necroware/nwX287/(threads)

Thread 1 (2021-10-04):

Share your project on PCBWay

kalgon, 2021-10-04:
Hi,

Could you share your project directly on PCBWay (https://www.pcbway.com/project/shareproject/) ?

It would be easier to order PCBs and you could get some money too ;-)

Regards,
Xavier

necroware, 2021-10-04:
Hi Xavier,

may be one day. I don't want to spread my projects all over the place, it makes it harder to maintain them and keep the versions up to day. I mean PCB Way is not the only one manufacturer. I'm also currently not registered on PCB Way and I don't think that I will get a lot of money from it anyway. I'll keep this request open for now, may be I'll change my mind one day.

However, it is currently super easy as well. I guess, everybody is able to drag and drop a file and if not, probably, my projects are not the right thing :D

Cheers,
Filipp

Closed 2023-12-30.

Thread 2 (2021-11-25):

Compatibility with the *B* and *C* variants

Jackowski3k, 2021-11-25:
Hello.

Out there are multiple versions of the Dallas RTC chip, among them the DS12B887 and DS12C887
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

How does it looks with the compatibility? I have tried various alternatives I could find online and they didn't worked on my systems.

necroware, 2021-11-25:
You can use this module with different ICs, so it is heavily dependent on what you are using. I used it with BQ3285 and BQ4285 depending on the mainboard requirements and both variants worked perfectly. Due to the datasheets the DS12C885 (used in DS12C887) is an extended version of the DS12B885 (used in DS12B887), which is again an extended version of the DS1285. The extended versions are a drop-in replacement for the older versions accordingly. The BQ3285 should be identical with DS12C885 and I had no mainboards so far, where it didn't work.

steeviebops, 2023-07-12:
This board, as built, is functionally equivalent to the DS12B887. The main difference between the 12887 and 12B887 is that the B variant exposes pin 21 of the internal RTC. This is the "RAM clear" pin, used for clearing CMOS settings via a jumper. Pin 21 is absent from a standard DS12887 module so it can't be cleared using the jumper method.

The DS12C887 contains an extra "century byte" so I imagine that the RTC would need to be different. I've seen some references to a DS12C885 but it seems to be hard to find.

necroware, 2023-12-30:
Thank you very much. I mentioned this in the documentation. The PCB itself exposes pin 21 already, so it is only a question of which pins to cut. I guess this can be closed.

Closed 2023-12-30.

Thread 4 (2021-12-14):

chips have the same code in kicad schematic

dataino-it, 2021-12-14:
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
chips have the same code in kicad schematic

necroware, 2021-12-14:
That's on purpose. The one represents the outer DIP and the other one the SO.

dataino-it, 2021-12-14:
Yes, I understood by opening the pcb

dataino-it, 2021-12-14:
can be. or 24 pin socket

necroware, 2021-12-14:
I renamed it simply in socket ;)

Closed 2021-12-14.

Thread 5 (2021-12-15):

Question about CR2025 vs 1225

atheros, 2021-12-15:
Hi,

Awesome job you did here, big thanks!

I want to order the components, but I see an issue. Readme calls for CR1220 / CR1225 battery holder while the silk screen layer has CR2025 marking.

So just to be sure, which is it? Or do all of those battery holders fit on the PCB?

Thanks!

ndemarco, 2021-12-17:
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

I'm seeing CR1220 in the silk layer.

The 2025 is a 20 mm diameter battery. The 12xx is a 12 mm diameter cell. They're not interchangeable.

necroware, 2021-12-17:
See #6

Closed 2021-12-17.

Thread 6 (2021-12-15):

Silk screen layer mentions CR2025 instead of CR1220/1225

atheros, 2021-12-15:
Hi,

Awesome job you did here, big thanks!

I want to order the components, but I see an issue. Readme calls for CR1220 / CR1225 battery holder while the silk screen layer has CR2025 marking.

So just to be sure, which is it? Or do all of those battery holders fit on the PCB?

Thanks!

necroware, 2021-12-15:
Oh, that's a mistake on the silk screen layer. The batter (holder) must be CR1220 (CR1225 is the same size). I'll fix the silk screen layer and make a fixed release.

necroware, 2021-12-15:
Fixed and release the new revision 1a:
https://github.com/necroware/nwX287/releases/tag/rev1a

Closed 2021-12-15.

Thread 7 (2021-12-17):

Include the symbol cache

ndemarco, 2021-12-17:
I'm fairly new to KiCad. Actually, I just installed it. I do use Altium for work, though.

It seems the symbol cache is missing.
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

necroware, 2021-12-17:
Kicad generates the *-cache.lib file automatically. Please don't use KiCad 5.99, that is a development version and you will have many issues using that one. The current official version is 5.1.12

necroware, 2021-12-17:
By the way, if you want just to order the PCBs, you don't need to use KiCad at all. Simply go into releases and download the gerber files, which you can use to make the order.  https://github.com/necroware/nwX287/releases

ndemarco, 2021-12-17:
Thank you 2x today (not seeing ver 1.a, not seeing I installed KiCad
preview). I really must wake up! Your videos are great. Very well done,
precise and clear.

KiCad interests me, so I prefer to go that way.

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

necroware, 2023-12-30:
done

Closed 2023-12-30.

Thread 9 (2022-09-02):

Xtal

jcarval, 2022-09-02:
Hi, my friend, can I solder the crystal in any way or the xtal has a like + and - side like capacitors? (sorry my nob question about crystals)
I have ordered some from alliexpress and they some have no marking and the legs are the same size.
In the photos you supplied I can see that some lettering in them, but could be coincidence .
Thank you!
Jorge

necroware, 2022-09-02:
Hi Jorge! You can solder it either way, they don't have polarity.
Cheers!

Closed 2022-12-05.

Thread 10 (2022-11-22):

"cmos checksum error defaults loaded" with BQ3285S RTC

theniwo, 2022-11-22:
Hi all.

I assembled an RTC-Module with the [nwX287](https://github.com/necroware/nwX287) PCB and a [BQ3285S](https://www.ebay.de/itm/324259367588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) RTC.

Now I am getting the "cmos checksum error defaults loaded".

The Battery Error is not indicated and the battery is fresh and has voltage.

I testet

* Loading BIOS or Setup defaults

* Flashing the BIOS with the latest ([WI7C 040197](https://theretroweb.com/motherboard/bios/wi7c-5f5ab87c0cb5d152278531.exe)) Award from [theretroweb](https://theretroweb.com/motherboards/s/msi-ms-5129-tr5#downloads)

* Checked continuity on all pins and legs on the RTC Module

What I noticed was that the time drifted forward and the seconds where erroraneous.

It goes like this: 1 - 19, 40, 0

What is going on here? Did I use the wrong RTC Chip?

May it be a counterfeit?

Did I damage it because it got a bit hot during soldering?

Can I rule the BIOS EEPROM out since it should be an issue with the RTC?

I have the original ODIN OEC12C887. Should I mod it to rule the BIOS EEPROM out?

necroware, 2022-12-05:
May be the BQ3285S is defective. The BIOS chip is not related.

necroware, 2023-12-30:
I don't think, that this is related to the module itself. Looks like an incompatibility or defect of the chip itself.

theniwo, 2025-05-22:
I changed the IC and it works now. The one I had was probably defective, or a counterfeit

Front:
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

Back
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

Working IC
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

Closed 2023-12-30.

Thread 11 (2022-11-26):

BQ3287MT

adamz464, 2022-11-26:
Unfortunately doesn't work (Alaris Cougar)...

necroware, 2022-12-05:
Ok, then I'd like to know, which module was previously in there, if the board works reliably with the original IC and what means "doesn't work"? Black screen, no boot, no POST codes?

adamz464, 2022-12-29:
BQ3287MT. Tested on both identical motherboards and with BQ3285S / LCS.

No boot (black screen). Some beeps are but didn't check about meaning (it
is MrBios)

necroware, 2022-12-29:
If it is beeping, the RTC module is probably ok. Usually the boards doesn't even get to the POST codes if the RTC module is dead. If it is beeping, then the basic initialization has been done successfully.

adamz464, 2023-01-17:
Accidentally got Alt12887 with DS12885S chip. It worked with this one picky
motherboard (Alaris Cougar).
So I desoldered DS chip and prepared next unit of NWX based on it. Result
the same (no screen).
Must compare pinout of these proejcts because must be difference between
them...

adamz464, 2023-01-17:
Found issue: #21 pin is present in ALT. After soldering this leg back to
your module then mobo boots

adamz464, 2023-01-26:
and...

> Message ID: ***@***.***>
>

adamz464, 2023-02-15:
and...

> Message ID: ***@***.***>
>

adamz464, 2023-02-28:
AND

necroware, 2023-02-28:
Ok, most mainboard don't use that pin, but yours seems to use it. This is the first one so far. I'll have to update the documentation and test what happens if I use it with pin 21 in another boards.

Thread 17 (2023-12-30):

Please add pin 1 silkscreen markings for the clock chip

feltel, 2023-12-30:
Recently I have had produced some PCBs using your fantasic dallas clock module replacements. I'm now in the process of assembling one module. It seems there is no (identifieable) pin 1 marking on the silkscreen for the clock chip. Looking around it seems that pin 1 is towards the crystal. To make thinks clear please add a marking on the silkscreen.

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

Thanks alot and have a nice 2024.

necroware, 2023-12-30:
The pin one is already marked by the footprint of the library. There is no need to add own markings.

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

Closed 2023-12-30.

Thread 19 (2024-03-12):

Use of RCL pin 21

shalseth, 2024-03-12:
First of all, thanks for this project. Looks like it's exactly what I need, and I appreciate the effort.

I have ordered a nwx287 to replace a Dallas  DS12887.

I'm unsure about this:
"Important: some mainboards seem to use /RCL pin 21, so cut it first if you are sure, that your mainboard doesn't use it."

Is there any safe way I can find out if my main board uses the RCL pin or not?

Any risk _not_ cutting and, and testing first?

The machine is a DEC Venturis 5100, Pentium 100, SIS 5501 chipset.

Text on Dallas module:
Dallas
DS12887
REALTIME
9538A2 067579

shalseth, 2024-03-12:
I'm closing as I guess it is sufficient to check the  pins on the original module in question

Thread 20 (2024-05-30):

Implementing DS1643 suppoort

Deftaudio, 2024-05-30:
Hi, just wondering if there is any way to implement DS1643 support which is 8k device?

necroware, 2024-05-30:
H, this is a completely different module. This project is to replace DS12887 and compatible modules, so the question if something different can be implemented is kind of unrelated. Even if DS1643 is also an RTC module, it's still another one.

If you have your old module, may be this video can be helpful to you:
https://youtu.be/ecTZtZhE9bI

Deftaudio, 2024-05-30:
I appreciate this, thank you, this video explains it very well.

Closed 2024-05-30.

Thread 23 (2025-07-20):

2 modules died

squelch41, 2025-07-20:
Hi,
1st of all, thank you for this project (and your great YT videos)
I have had 2 of these modules and fitted them to an  ICL NB386S laptop (a rebaged siemens-nixdorf PCD-3Nsx) - 386 sx machine, dalas clock.

The first one failed after a few days - would crash on start up often before bios beep and lose all bios settings - I think the internal memory on the bq3285s failed.
The the second one now has a failed clock - the setting save and the bios gets through ok but time is always lost.

It's possible I just have been unlucky and had 2 defective chips, but it seems a bit odd?

Just wondering if there is a way these modules could be being fried?

squelch41, 2025-07-20:
That's interesting, thanks.

At first glace, the RTC clock, once set, does keep time.
If I manually set the time in DOS, then checkit says the RTC test passes, but if I run it a few mins later, though it still passes, the two clocks have drifted -- I will certainly check the crystal (though because of space I had to solder in the board!)

And if it's not that, I guess I was just unlucky with my chips.

Thanks again!

Closed 2025-07-20.

Thread 24 (2025-07-22):

Time saving but setings erasing

486-dx, 2025-07-22:
So my nw287 works it saves my time  but it wont save my hard drive configuration i dont know what to do

486-dx, 2025-07-22:
So the mainbord is genoa ga-486 am the bios is award bios l4854303 the rtc is on the picture the rtc is socketed pins cut of are visible on the picture the batery tests out at 3.24 volts  and  other things seem ok the chip soddered  is ds 12885s  and  i dont think i see any write protection jumpers i didnt  add info because i tought you would not respond

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

necroware, 2025-07-22:
> i didnt add info because i tought you would not respond

I'm active in the community and as a software developer since many many years. Please don't get wrong, but the chance for a bad ticket to be ignored is much higher. If you really in search for help, try to create your tickets as good as possible, otherwise there is no point to create those anyway.

Regarding your issue Genoa ga-486 is not known to me. Do you mean Gigabyte? In such a case it's better to find the board on the retro web project and link it in the issue. You didn't mention which RTC module was originally used in your board, but if you still have it, compare which pins are cut off there. From the picture of your nwX287, I see for example, that pin 21 is still soldered on your module. That pin is responsible for memory reset and if this pins is bound to ground on your board it will erase the internal memory all the time. May be you want to remove that pin. Also your chip looks kind of sketchy tbh. Unfortunately there are a lot of fakes out there.
