necroware/nwX287/(commit log)

2021-06-16 Fixed battery position
    [nwX287.kicad_pcb]
2021-06-16 Improved silk layout
    [nwX287.kicad_pcb]
2021-08-07 Update README, project cleanup
    [nwX287.kicad_pcb, nwX287.sch]
2021-08-07 Fix pin name for bq4285
    [nwX287.kicad_pcb, nwX287.sch]
2021-12-14 Renamed socket name in the schematics
    [nwX287.sch]
2021-12-15 Fixed battery model on the silk screen
    [nwX287.kicad_pcb, nwX287.sch]
2021-12-21 Fixed crystal frequency 32.768kHz instead 32kHz
    [nwX287.kicad_pcb, nwX287.sch]
2023-12-30 Updated project to KiCad 7.0
    [nwX287.kicad_pcb, nwX287.kicad_sch, nwX287.sch]
2023-12-30 Added Intl/Mot jumper
    [nwX287.kicad_pcb, nwX287.kicad_sch]
2023-12-30 Updated jumper information
    [nwX287.kicad_pcb]
